cbcotten/KCprj_GTC-02-RTD/ModulePinSelection.xlsx

Sheet: Low Profile
 |  |  |  |  |  |  |  |  | Pin Tail |  | Pin Tail |  | 0.115 | Samtec TSW-1xx-23-G-S Pin Tail Length shown
Pin Length Calcs |  | INCH |  |  |  |  |  | Module PCB |  |  |  | 0.063
0.063 | Module Thickness |  |  |  |  |  |  | 0.06 | SLW Body |  | Std Pin Body | 0.1 | 0.1
0.063 | Main PCB thickness |  |  |  |  |  |  | 0.18 | Socket |  |  |  | 0.23 | 0.24 | PCB Gap
0.18 | Low Profile Socket Height |  |  | Samtec Low Profile SLW socket strip |  |  |  |  | Body | Receptacle | Pin |  |  | 0.14 | Gap- Main PCB to Std Pin Body
0.06 | Low Profile Pin Body (plastic) |  |  |  |  |  |  | Main PCB |  |  |  | 0.063 |  | 0.292 | Module Height @ Pin Tail Tops
0.025 | min protrosion for soldering |  |  |  |  |  |  |  |  |  | Pin | 0.098
0.098 | max clearance under pcb
0.1 | Standard socket pin body thickness |  |  |  |  |  |  | Base |  |  |  |  |  | Under Module Board
Mill-Max Receptacle |  |  |  | From top of recep. |  |  |  |  |  |  |  |  |  | Pin Length
Part Num | OAL | Above PCB | Below PCB | Min Pin Depth | Max Pin Depth | Major Dia | Minor Dia | PCB Hole Dia | Mount | Dist | Price | MOQ | PN | Module to Recept | Min Pin | Max Pin
0284 | 0.250 | 0.105 | 0.082 | 0.103 | 0.210 | 0.125 | 0.068 | 0.07 | solder | Mouser | 1.62 | 1 |  | 0.035 | 0.138 | 0.245
0285 | 0.180 | 0.090 | 0.027 | 0.086 | 0.251 | 0.08 | 0.062 | 0.065 | solder | Mouser | 0.5 | 1 | 0285-0-15-15-16-27-10-0 | 0.050 | 0.136 | 0.301
0287 | 0.090 | 0.045 | -0.018 | 0.083 | 0.206 | 0.08 | 0.062 | 0.065 | solder |  |  |  |  | 0.095 | 0.178 | 0.301
0291 | 0.145 | 0.018 | 0.064 | 0.083 | 0.12 | 0.079 | 0.061 | 0.067 | press | Mouser | 0.61 | 1 | 0291-0-15-15-16-27-10-0 | 0.122 | 0.205 | 0.242
0330 | 0.310 | 0.05 | 0.197 | 0.091 | 0.285 | 0.09 | 0.071 | 0.079 | press |  |  |  |  | 0.090 | 0.181 | 0.375
0415 | 0.190 | 0.018 | 0.109 | 0.083 | 0.165 | 0.078 | 0.06 | 0.063 | solder | Mouser | 0.81 | 1 | 0415-0-15-15-16-27-10-0 | 0.122 | 0.205 | 0.287
6021 | 0.190 | 0.018 | 0.109 | 0.083 | 0.165 | 0.078 | 0.06 | 0.062 | solder | Digikey | 0.73 | 1 | 6021-0-15-80-16-27-10-0 | 0.122 | 0.205 | 0.287
7305 | 0.105 | 0.014 | 0.028 | 0.083 | 0.175 | 0.077 | 0.058 | 0.06 | solder | Mouser | 1.38 | 1 | 7305-0-15-15-47-14-10-0 | 0.126 | 0.209 | 0.301
8679 | 0.25 | 0.066 | 0.121 | 0.094 | 0.21 |  | 0.069 | 0.071 | solder |  |  |  |  | 0.074 | 0.168 | 0.284
 | Low Profile Summary
Application |  | Mfg | MPN |  | Descr
Digital Header |  | Samtec | TLW-1xx-06-G-S |  | Low profile header pin, .105" mating length, .105" tail length
Digital Header |  | Samtec | SLW-1xx-01-x-S |  | Low profile socket header, 0.18" body height, 0.1" pitch
3.5mm TB Pin |  | Samtec | TSW-1xx-07-G-S |  | Standard 0.1" header pin long enough to reach receptacle, 0.230" contact mating length
3.5mm TB Socket |  | Mill-Max | 0291-0-15-15-16-27-10-0 |  | Press fit receptacle, 0.022-0.034" pin dia

Sheet: Standard Profile
 |  |  |  |  |  |  |  |  | Pin Tail |  | Pin Tail |  | 0.111 | 0.648 | B- Total Pin Length
Pin Length Calcs |  | INCH |  |  |  |  |  | Module PCB |  |  |  | 0.063 |  | Samtec SSW socket insertion depth 0.145 to 0.250
0.063 | Module Thickness |  |  |  |  |  |  | 0.1 | TSW body |  | TSW body | 0.098 | 0.098
0.063 | Main PCB thickness |  |  |  |  |  |  | 0.335 | SSW |  |  |  | 0.439 | 0.435 | PCB Gap
0.335 | Socket Body Height |  |  | Samtec Low Profile SLW socket strip |  |  |  |  | Socket | Receptacle | Pin |  |  | 0.337 | Gap- Main PCB to Std Pin Body
0.1 | Socket Pin Body |  |  |  |  |  |  | Main PCB |  |  |  | 0.063 |  | 0.483 | Module Height @ Pin Tail Tops
0.025 | min protrosion for soldering |  |  |  |  |  |  |  |  |  | Pin | 0.098
0.098 | max clearance under pcb
0.1 | Std Pin body for receptacle |  |  |  |  |  |  | Base |  |  |  |  |  | Under Module Board
Mill-Max Receptacle |  |  |  | From top of recep. |  |  |  |  |  |  |  |  |  | Pin Length
Part Num | OAL | Above PCB | Below PCB | Min Pin Depth | Max Pin Depth | Major Dia | Minor Dia | PCB Hole Dia | Mount | Dist | Price | MOQ | PN | Module to Recept | Min Pin | Max Pin
0284 | 0.250 | 0.105 | 0.082 | 0.103 | 0.210 | 0.125 | 0.068 | 0.07 | solder | Mouser | 1.62 | 1 |  | 0.232 | 0.335 | 0.442
0285 | 0.180 | 0.090 | 0.027 | 0.086 | 0.251 | 0.08 | 0.062 | 0.065 | solder | Mouser | 0.5 | 1 | 0285-0-15-15-16-27-10-0 | 0.247 | 0.333 | 0.498
0287 | 0.090 | 0.045 | -0.018 | 0.083 | 0.206 | 0.08 | 0.062 | 0.065 | solder |  |  |  |  | 0.292 | 0.375 | 0.498
0291 | 0.145 | 0.018 | 0.064 | 0.083 | 0.12 | 0.079 | 0.061 | 0.067 | press | Mouser | 0.61 | 1 | 0291-0-15-15-16-27-10-0 | 0.319 | 0.402 | 0.439
0330 | 0.310 | 0.05 | 0.197 | 0.091 | 0.285 | 0.09 | 0.071 | 0.079 | press |  |  |  |  | 0.287 | 0.378 | 0.572
0415 | 0.190 | 0.018 | 0.109 | 0.083 | 0.165 | 0.078 | 0.06 | 0.063 | solder | Mouser | 0.81 | 1 | 0415-0-15-15-16-27-10-0 | 0.319 | 0.402 | 0.484
6021 | 0.190 | 0.018 | 0.109 | 0.083 | 0.165 | 0.078 | 0.06 | 0.062 | solder | Digikey | 0.73 | 1 | 6021-0-15-80-16-27-10-0 | 0.319 | 0.402 | 0.484
7305 | 0.105 | 0.014 | 0.028 | 0.083 | 0.175 | 0.077 | 0.058 | 0.06 | solder | Mouser | 1.38 | 1 | 7305-0-15-15-47-14-10-0 | 0.323 | 0.406 | 0.498
8679 | 0.25 | 0.066 | 0.121 | 0.094 | 0.21 |  | 0.069 | 0.071 | solder |  |  |  |  | 0.271 | 0.365 | 0.481
 | Low Profile Summary
Application |  | Mfg | MPN |  | Descr
Digital Header |  | Samtec | TSW-1xx-07-G-S |  | Standard 0.1" pitch header pin (0.230 head, 0.100 tail)
Digital Header |  | Samtec | SSW-1xx-01-G-S |  | Standard 0.1" header socket
3.5mm TB Pin |  | Samtec | TSW-1xx-15-G-S |  | Standard 0.1" header pin long enough to reach receptacle, 0.230" contact mating length
3.5mm TB Socket |  | Mill-Max | 0291-0-15-15-16-27-10-0 |  | Press fit receptacle, 0.022-0.034" pin dia
Shield Digital Socket |  | Sullins | PPPCxx1LFBN-RC |  | Standard 0.1" header socket
Module Digital Pin |  | Sullins | PRPCxxxSAAN-RC |  | Standard 0.1" header pin (0.230 head, 0.120 tail)
Module Sensor Pin |  | Sullins | PRPCxxxSACN-RC |  | Standard 0.1" header pin (0.230 head, 0.320 tail)

Sheet: Sheet3
Module | Profile | Application | PN | Digikey Price
Adafruit MAX31865 | Standard | Digital Shield Socket | SSW-108-01-G-S
 | Standard | Digital Module pins | TSW-108-09-G-S | $0.94
 | Standard | Shield Sensor Socket
 | Standard | Module Sensor Pins | TSW-110-15-G-S | $1.18
 | Standard | Shield Digital Socket | PPPC081LFBN-RC | $0.89
 |  | Module Digital Pins | PRPC008SAAN-RC | $0.26
 |  | Shield Sensor Socket | 0291-0-15-15-16-27-10-0 | $0.73
 |  | Module Sensor Pin | PRPC004SACN-RC | $0.25
