cbcotten/KCprj_GTC-02-RTD/GTC_02_RTD.xlsx

 |  |  |  |  |  |  | Board Qty: | 1
 |  |  |  |  |  |  | Total Cost: | $41.80 |  |  |  | $59.73 |  |  |  |  |  | $37.35 |  |  |  |  |  | $56.78 |  |  |  |  |  | $103.86 |  |  |  |  |  | $14.18
 |  |  |  |  |  |  | Unit Cost: | $41.80
Global Part Info |  |  |  |  |  |  |  |  | Digi-Key |  |  |  |  |  | Farnell |  |  |  |  |  | Mouser |  |  |  |  |  | Newark |  |  |  |  |  | Rs Components
Refs | Value | Desc | Footprint | Manf | Manf# | Qty | Unit$ | Ext$ | Avail | Purch | Unit$ | Ext$ | Cat# | Doc | Avail | Purch | Unit$ | Ext$ | Cat# | Doc | Avail | Purch | Unit$ | Ext$ | Cat# | Doc | Avail | Purch | Unit$ | Ext$ | Cat# | Doc | Avail | Purch | Unit$ | Ext$ | Cat# | Doc
J1-J8 | TB_PhxContact_MKDS-1.5-3-5.08 |  | CBC_Connectors:TB_PhxCon_MKDS-1.5-3-5.08 | Phoenix Contact | 1715734 | 8 | $1.69 | $13.52 | 1990 |  | $1.79 | $14.32 | 277-1264-ND | Link (http://www.digikey.com/scripts/DkSearch/dksus.dll?WT.z_header=search_go&lang=en&keywords=1715734%20) |  |  | $1.69 | $13.52 | 3041530 | Link (http://it.farnell.com/webapp/wcs/stores/servlet/Search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) | 1640 |  | $1.78 | $14.24 | 651-1715734 | Link (http://www.mouser.com/Search/Refine.aspx?Keyword=1715734%20) |  |  | $1.78 | $14.24 | 71C4096 | Link (http://www.newark.com/webapp/wcs/stores/servlet/Search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) | 110 |  | $1.77 | $14.18 | 193-0570 | Link (http://it.rs-online.com/web/c/?searchTerm=1715734%20)
MOD1,MOD2 | Adafruit_MAX31865_0291 |  | CBC_Modules:Adafruit-3328_MAX31865_0291 | Adafruit | 3328 | 2 | $6.86 | $13.71 | 27 |  | $14.95 | $29.90 | 1528-1804-ND | Link (http://www.digikey.com/scripts/DkSearch/dksus.dll?WT.z_header=search_go&lang=en) |  |  | $6.86 | $13.71 | 1258665 | Link (http://it.farnell.com/bomar-interconnect/3328505/rf-coaxial-adapter-bnc-jack-f/dp/1258665) | 48 |  | $14.99 | $29.98 | 485-3328 | Link (http://www.mouser.com/ProductDetail/Adafruit/3328/) |  |  | $41.41 | $82.82 | 92N3759 | Link (http://www.newark.com/duratool/3328/crimp-die-modular-plug-crimper/dp/92N3759) | 6 |  |  |  | 400-700 | Link (http://it.rs-online.com/web/p/microcontroller/0400700/)
ENCLOSURE1 | Bud_Industries_DMB-4772 |  | CBC_Mechanical:Enclosure-DMB-4772 | Bud Industries | DMB-4772 | 1 | $6.80 | $6.80 | 207 |  | $6.80 | $6.80 | 377-1809-ND |  |  |  | $10.12 | $10.12 | 2762454 | Link (http://it.farnell.com/bud-industries/dmb-4772/contenitore-guida-din-abs-pc-grigio/dp/2762454) | 118 |  | $7.66 | $7.66 | 563-DMB-4772 | Link (http://www.mouser.com/ProductDetail/Bud-Industries/DMB-4772/) |  |  | $6.80 | $6.80 | 12T6241 | Link (http://www.newark.com/bud-industries/dmb-4772/enclosure-din-rail-abs-lt-gray/dp/12T6241)
J9 | Pin_Header_Straight_2.54mm_1x06 |  | CBC_Connectors:Pin_Header_Straight_1x06_Pitch2.54mm | Sullins | PRPC006SAAN-RC | 1 | $0.23 | $0.23 | 2016 |  | $0.23 | $0.23 | S1011EC-06-ND | Link (http://www.digikey.com/scripts/DkSearch/dksus.dll?WT.z_header=search_go&lang=en)
HDR_PIN1 | HDRPIN-0.1"-1row_0.23Head-0.12Tail-Gold-20pos |  |  | Sullins | PRPC020SAAN-RC | 1 | $0.46 | $0.46 | 1414 |  | $0.46 | $0.46 | S1011EC-20-ND | Link (http://www.digikey.com/scripts/DkSearch/dksus.dll?WT.z_header=search_go&lang=en)
HDR_PIN2 | HDRPIN-0.1"-1row_0.23Head-0.32Tail-Gold-10pos |  |  | Sullins | PRPC010SACN-RC | 1 | $0.40 | $0.40 |  |  | $0.40 | $0.40 | S1131EC-10-ND | Link (http://www.digikey.com/scripts/DkSearch/dksus.dll?WT.z_header=search_go&lang=en)
RECEPTACLE1-RECEPTACLE8 | RCPT-MillMax-0291-0-15-15-16-27-10-0 |  |  | Mill-Max | 0291-0-15-15-16-27-10-0 | 8 | $0.61 | $4.90 | 6082 |  | $0.73 | $5.84 | ED90534-ND | Link (http://www.digikey.com/scripts/DkSearch/dksus.dll?WT.z_header=search_go&lang=en) |  |  |  |  |  |  | 1624 |  | $0.61 | $4.90 | 575-0291015151627 | Link (http://www.mouser.com/Search/Refine.aspx?Keyword=0291-0-15-15-16-27-10-0%20)
HDR_SKT1,HDR_SKT2 | HDRSKT-0.1"P-0.335"B-0.126"T-Gold_1x08 |  |  | Sullins | PPPC081LFBN-RC | 2 | $0.89 | $1.78 | 41805 |  | $0.89 | $1.78 | S7041-ND | Link (http://www.digikey.com/scripts/DkSearch/dksus.dll?WT.z_header=search_go&lang=en)
