cbcotten/KCprj_GTC-02-RTD/GTC_02_RTD.kicad_pcb

## KiCad design GTC_02_RTD.kicad_pcb (2017-06-28)

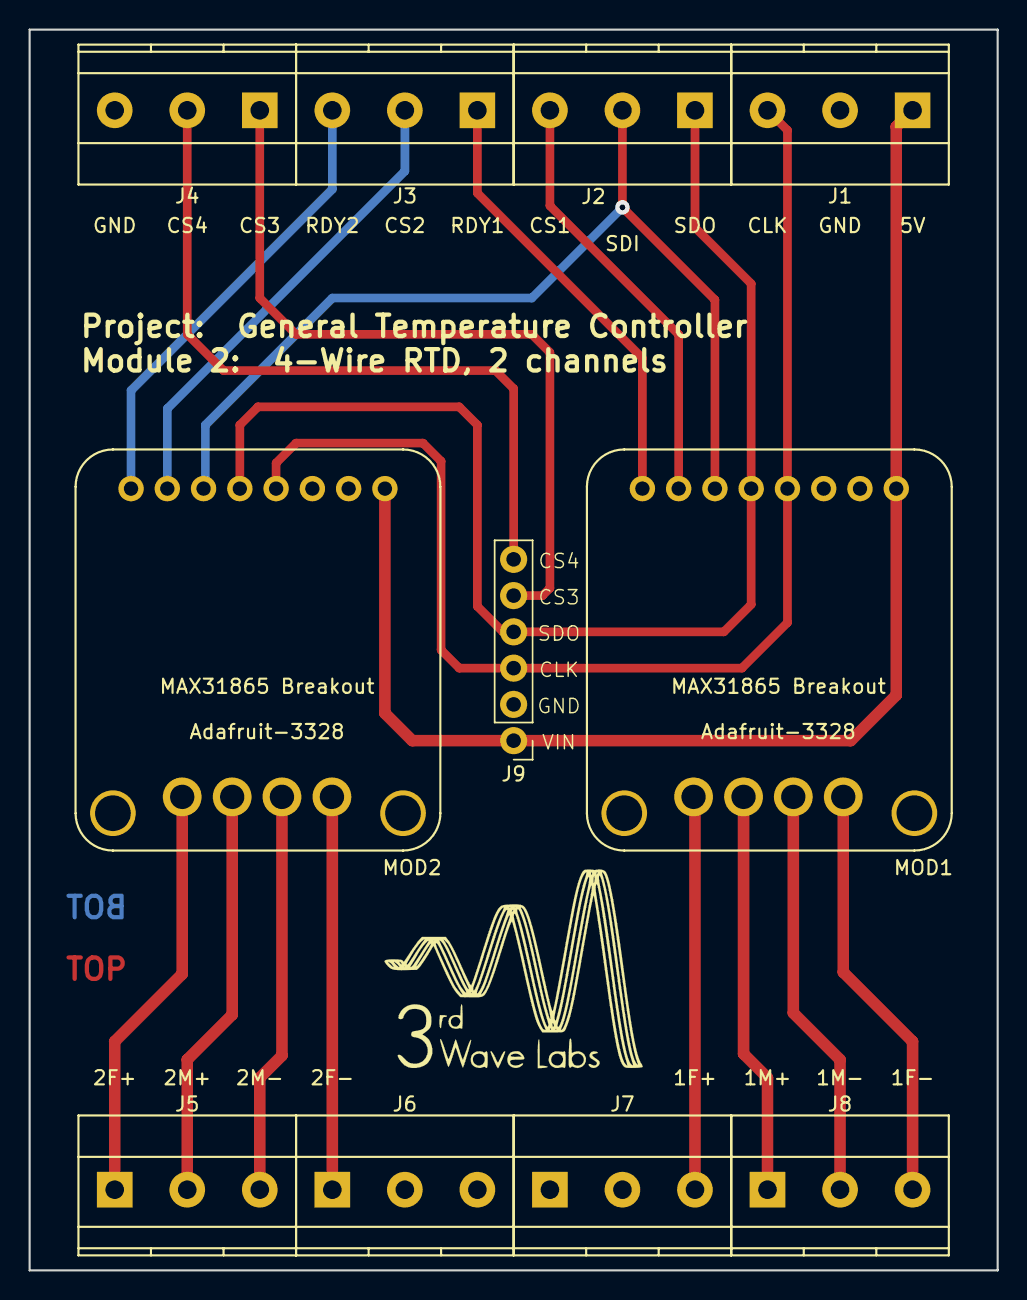
[picture p1: board GTC_02_RTD.kicad_pcb from above]

Board: 2 copper layers, 67.8 x 86.9 mm, 12 parts (0 on the bottom side), 20 nets.

Parts:
ENCLOSURE1: Bud_Industries_DMB-4772; Enclosure-DMB-4772
J1, J2, J3, J4, J5, J6, J7, J8: TB_PhxContact_MKDS-1.5-3-5.08; TB_PhxCon_MKDS-1.5-3-5.08
J9: Pin_Header_Straight_2.54mm_1x06; Pin_Header_Straight_1x06_Pitch2.54mm
MOD1, MOD2: Adafruit_MAX31865_0291; Adafruit-3328_MAX31865_0291

Connections:
CLK: J1.3, J9.3, MOD1.4, MOD2.4
CS1: J2.3, MOD1.7
CS2: J3.2, MOD2.7
CS3: J4.1, J9.5
CS4: J4.2, J9.6
GND: J1.2, J4.3, J9.2, MOD1.2, MOD2.2
HTR1_SHIELD: J6.2, J6.3, J7.1, J7.2
RDY1: J3.1, MOD1.8
RDY2: J3.3, MOD2.8
RTD1_F+: J7.3, MOD1.9
RTD1_F-: J8.3, MOD1.12
RTD1_M+: J8.1, MOD1.10
RTD1_M-: J8.2, MOD1.11
RTD2_F+: J5.1, MOD2.9
RTD2_F-: J6.1, MOD2.12
RTD2_M+: J5.2, MOD2.10
RTD2_M-: J5.3, MOD2.11
SDI: J2.2, MOD1.6, MOD2.6
SDO: J2.1, J9.4, MOD1.5, MOD2.5
VIN: J1.1, J9.1, MOD1.1, MOD2.1
