cbcotten/KCprj_GTC-02-RTD/(commit log)

2017-06-28 Libraries, Footprints, and Project files for GTC
    [BOMparts.sch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]
2018-03-15 Created New Repo KCprj_GTC-02-RTD from subdirectory in KiCAD_Repo, and added .gitignore, initial commit to new repo
2018-03-18 Rev 2 Schematic
    [BOMparts.sch, GTC_02_RTD.sch]
